AZ-James/Original-Space/电赛2026/技术报告/stm32程序逻辑图.png

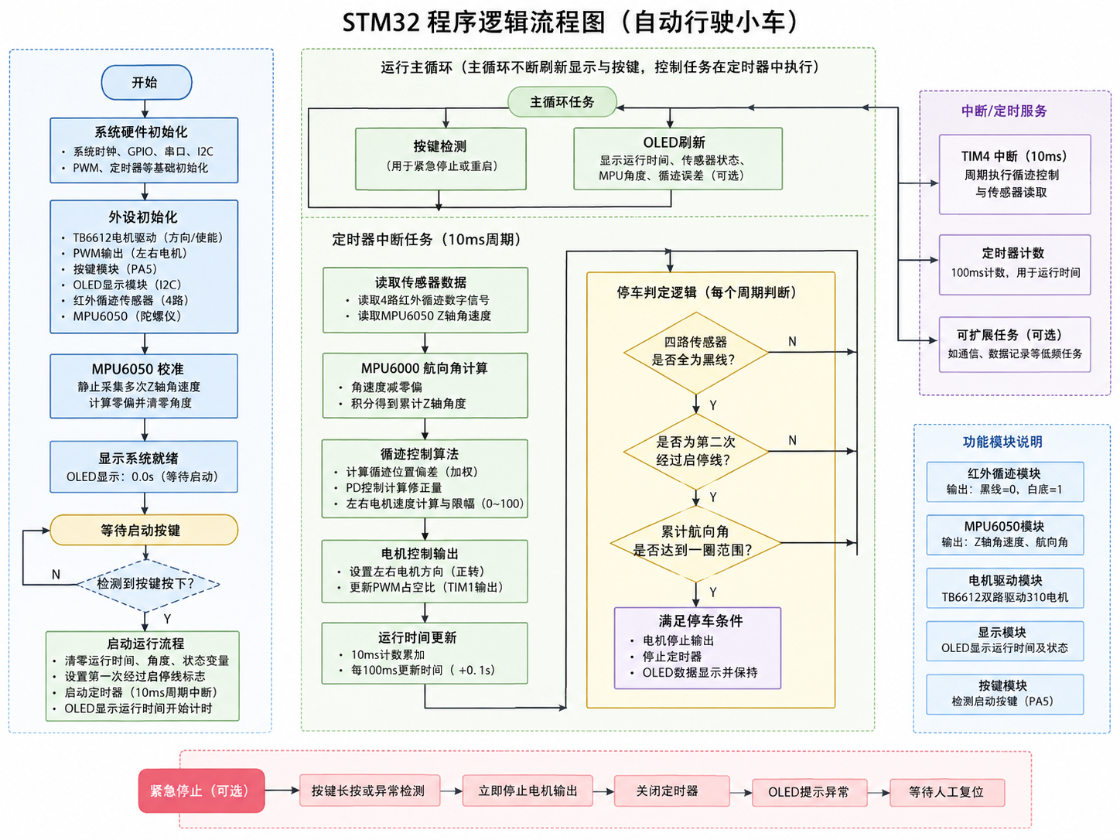
电赛2026/技术报告/stm32程序逻辑图.png
