AZ-James/Original-Space/README.md

# Original Space

## 说明
***A-Zealous*** 的元初空间，大存档器

后面闲着没事干可能也会传一些值得上传的东西上来吧
<p align="right"><i>（写于2026.11.4）</i></p>

## 上传摘要
- 26.11.10 对2026电赛的一部分代码与资料进行了留档
- 26.11.11 上传电赛视觉代码和技术报告资料

  其中视觉代码作者为队友 ***BrightGates***（https://github.com/BrightGates）

  底盘代码一部分为 ***桂花韵龙井*** 编写
