AZ-James/Original-Space/电赛2026/视觉代码/树莓派完整快照/diansai/README.md

# diansai ????

??????Python????????????????`tracker.service`????????

## ??

- `detect_rect.py`???????????????????????
- `vision_observe.py`???????????????????
- `ball_controller.py`???????????????????
- `pulse_controller.py`?????????????????????????
- `motor_init.py`??????????/?????
- `zdt_motor.py`?ZDT??????????????????
- `test_enc_simple.py`????????????????

## ????????????

```bash
python3 pulse_controller.py --target centre --max-pulses 6
python3 pulse_controller.py --target left --max-pulses 10
python3 pulse_controller.py --target right --max-pulses 10
```

????8????????????????12???????0.10--0.15??
??????????2????????????????????????????????
????????????120 px/s???????????????0??

## ??????

???????????????????

```text
????????
(69,243), (567,238), (567,277), (69,290)
??????????????????
(95,243), (542,238), (542,277), (95,290)
?????????????
(355,261), (211,264), (492,257)
```

???????????**??????????**??????????????????????????????
??????????????????/???????????
?????Hough??????????????????????

??????

```bash
cd /home/bg/diansai
python3 vision_observe.py
```

?????????????

```bash
python3 detect_rect.py
```

## ????/??

```bash
python3 motor_init.py
```

??????????????????`L/U`???

## ????????????

```bash
python3 pulse_controller.py --target centre --max-pulses 6
python3 pulse_controller.py --target left --max-pulses 10
python3 pulse_controller.py --target right --max-pulses 10
```

????8????????????????12???????0.10--0.15??
??????????2????????????????????????????????
????????????120 px/s???????????????0??

## ??????

???????????????????

```bash
python3 ball_controller.py --dry-run
```

???????????

```bash
python3 ball_controller.py --port /dev/ttyUSB0
```

???????????????????????????????????????????
???????????2?????`Space`???????????????????????
????????????????`--motor-sign 1`????????????????
`--motor-sign -1`?

????

- `Space`????????????????/???
- `1/2/3`????????????
- `E`?????????????????
- ????150 px/s????????`OVERSPEED`???????`Space`???
- `Q/Esc`?????????

## ????

?????????????????????266??????29.925????????
???30.0375??267???????????18????????????24??
????????????????????????????????????

## ????????????

```bash
python3 pulse_controller.py --target centre --max-pulses 6
python3 pulse_controller.py --target left --max-pulses 10
python3 pulse_controller.py --target right --max-pulses 10
```

????8????????????????12???????0.10--0.15??
??????????2????????????????????????????????
????????????120 px/s???????????????0??

## ??????

- ?????RS485???????????????????
- ????USB-RS485 `/dev/ttyUSB0`?
- ??????GPIO UART????RS485 A/B?
- ??????PL2303/FTDI??RTS?
- ??????????????????
- `python3 test_enc_simple.py --port /dev/ttyUSB0`???????
- `python3 zdt_motor.py --port /dev/ttyUSB0`??????????????

## 2026-08-01 当前推荐控制方案

当前推荐入口为 `pulse_controller.py`。它不再使用固定“角度×时间→位移”模型，而是采用轻量反馈：5.5°起步、未克服静摩擦时每次增加0.5°、最高7°；检测到运动立即回零，钢球稳定后重新测量实际落点。环境较稳定，因此只使用简单中位数/MAD滤噪和3秒稳定窗口，不进行复杂在线辨识。

```bash
python3 pulse_controller.py --target centre --max-pulses 8
python3 pulse_controller.py --target left --max-pulses 10
python3 pulse_controller.py --target right --max-pulses 10
```

轨道和目标坐标统一在 `vision_calibration.json` 中调整。完整实验依据、安全约束和文件说明见 `CONTROL_UPDATE_2026-08-01.md`。旧版已备份为 `pulse_controller_before_adaptive.py`，仅供回看。

注意：电机 `enable()` 后第一条位置命令前必须等待至少0.5秒；当前程序等待0.6秒。±30°硬限位、边缘保护、视觉丢失回零和超速中止始终有效。
