AZ-James/Original-Space/电赛2026/视觉代码/树莓派完整快照/diansai/CONTROL_UPDATE_2026-08-01.md

# 2026-08-01 鲁棒控制更新

## 核心结论

钢球系统不能使用“某角度持续某时间必然移动固定像素”的精确模型。轻微弧度、动静摩擦差异、每次装配/锁定偏移和钢球反射都会改变结果。一次实验得到的角度、速度和位移只能用于确定保守范围，不能当作固定标定常数。

当前 `pulse_controller.py` 已改成反馈驱动的自适应控制：

1. 每次动作前重新测量钢球位置和当前画面噪声；
2. 从 5.5°开始，未克服静摩擦时逐级增加；右侧上坡区14°仍不足，但+15°测试产生约204 px/s峰值，因此正式程序上限恢复到14°，禁止继续盲目增角；
3. 运动触发阈值由当前位置噪声的中位数绝对偏差（MAD）计算，并设宽松上下界；
4. 检测到真实位移或同方向速度后立即快速回到 0°；
5. 不预测滑行距离，等待真正稳定后重新测量落点，再决定下一步；
6. 换向后重新从小倾角搜索，不假设左右摩擦相同；
7. 视觉丢失、速度过高、进入边缘保护区或长期不稳定时均回零并中止；
8. ±30°机械硬限位仍独立存在（266 脉冲 = 29.925°），任何控制参数都不能越过；当前正式控制另设 14°上限。

轨道由右侧电机带动时会靠近或远离镜头，镜头畸变使静止钢球在倾斜画面中也产生位置相关的像素偏移，而且越靠右越明显。因此倾斜状态的坐标只用于相对运动检测；只有回到0°并稳定后，才与三个目标坐标比较。

环境目前较稳定，因此只保留小范围角度自适应和简单噪声统计，不做复杂在线模型辨识。稳定判定窗口为 3 秒，兼顾可靠性和控制速度。

后续右移测试发现，平台开始倾斜时滤波速度可能先产生短暂尖峰，而钢球原始位置尚未发生同方向位移。因此运动启动条件已进一步简化为“原始位置确实向目标方向移动”；速度不再触发回零，只用于超速安全检查。

三个目标点和轨道四点继续从 `vision_calibration.json` 读取，装配小幅位移时只需修改该文件，不应修改控制算法。

## 本轮有效实验

- 当前锁定零位下，钢球曾在约 x=403 静止；这只是静摩擦造成的一个静止位置，不是唯一固定“最低点”。
- 在 x≈403 时，-1° 至 -5°未产生可信的永久运动；-6°能克服静摩擦。
- 快速 6°阶跃即使很短也会产生过大速度：一次 +6°约 0.124 秒后回零，钢球最大观测速度约 358 px/s，并接近右边缘。此方式已判定不适合继续使用。
- 将倾斜过程降到 5 RPM，并在检测到运动后回零，从 x≈413.6 到 x≈376.6，最大速度约 85.9 px/s。
- 再改为 3 RPM 慢速接近、直接使用原始视觉位置提前触发、80 RPM快速回零后，从 x≈376.7 到 x≈363～364，最大速度约 51.3 px/s。
- 中间目标 x=355，当前钢球距目标约 9 px，已进入 ±15 px 容差；测试结束时已发送绝对 0°。

上述数值只记录实验事实。程序不会依赖“每次移动约 13 px”之类的假设。

## 文件状态

- `pulse_controller.py`：新的自适应、事件触发控制器；已通过语法和参数检查。
- `pulse_controller_before_adaptive.py`：修改前备份，仅用于回看，禁止作为当前实机方案运行。
- `motion_observe_headless.py`：纯视觉无界面观察，不打开电机串口。
- `hold_angle_test.py`、`impulse_test.py`、`slow_tilt_test.py`：本轮实验脚本，不作为比赛入口。
- `detect_rect.py`：用户原始视觉测试程序，保持原样。

## 运行方式

先只观察：

```bash
cd /home/bg/diansai
python3 motion_observe_headless.py
```

控制到目标：

```bash
python3 pulse_controller.py --target centre --max-pulses 8
python3 pulse_controller.py --target left --max-pulses 10
python3 pulse_controller.py --target right --max-pulses 10
```

电机板没有返回数据。`enable()` 后必须等待至少 0.5 秒再发送第一条位置命令，否则第一条命令可能被忽略；当前代码等待 0.6 秒。无论正常完成还是异常退出，控制器都会在 `finally` 中再次发送绝对 0°。

## 尚需验证

自适应程序已经整合本轮有效策略，但尚未从远距离分别完整跑通左、中、右三个目标。后续验证必须逐个目标进行，观察真实落点后反馈调整，不能用一次实验拟合出的精确模型直接放大运行。
