AZ-James/Original-Space/电赛2026/R1三轮、四轮两驱小车底板（方形）-二维图纸.dxf

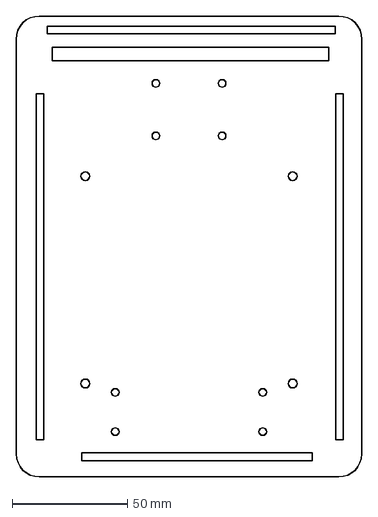
[picture p14: CAD file, 2026-11-10]
电赛2026/R1三轮、四轮两驱小车底板（方形）-二维图纸.dxf
150.0 x 200.0 mm
