AZ-James/Original-Space/电赛2026/车体建模/摆杆装配.stp

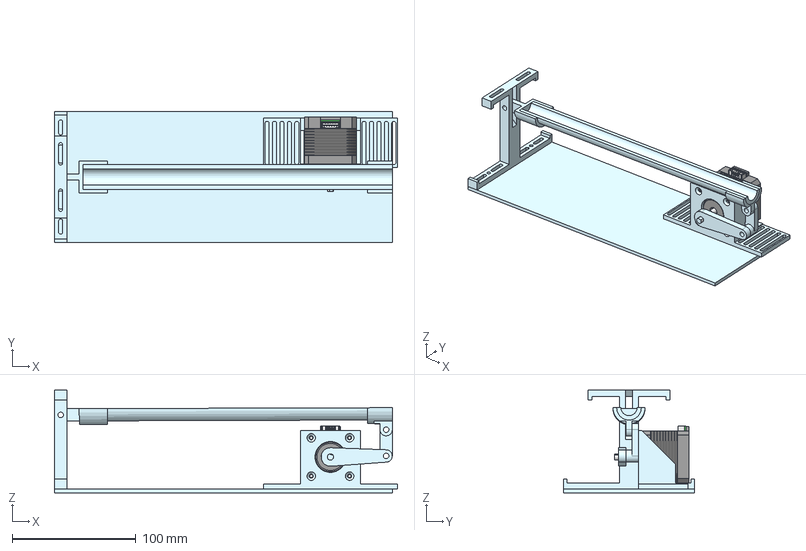
[picture p15: CAD file, 2026-11-10]
电赛2026/车体建模/摆杆装配.stp
277.2 x 106.0 x 83.0 mm
菁攫
42电机底座
摄像头支架及活页
步进连杆
Bottom
Sheet_metal
Top_body
Axis
625ZZ_001 x 2
Sticker
C-440054-6
PCB
Conn_cover
M3x16-Vis x 4
水管活页
阨奪
水管连杆
蟀裝2
