AZ-James/Original-Space/电赛2026/Drawing1.dxf

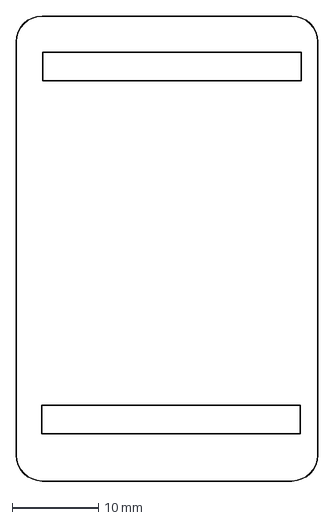
[picture p16: CAD file, 2026-11-10]
电赛2026/Drawing1.dxf
35.0 x 54.0 mm
