AZ-James/Original-Space/电赛2026/车体建模/树莓派底座.3mf

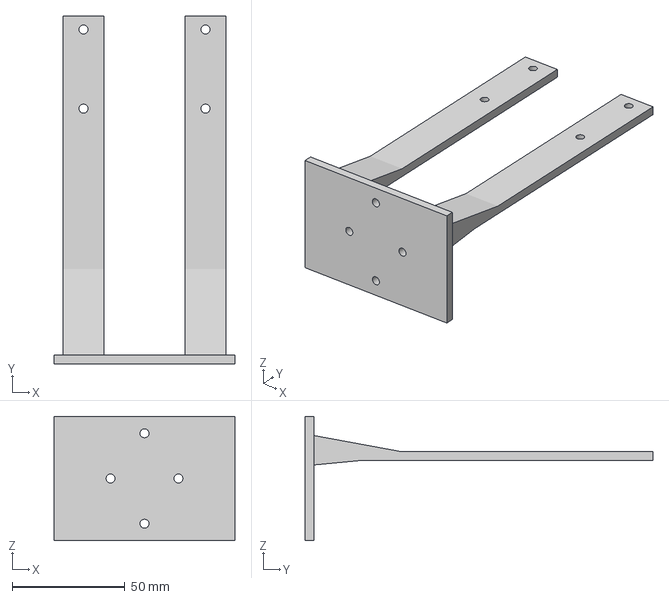
[picture p17: CAD file, 2026-11-10]
电赛2026/车体建模/树莓派底座.3mf
80.0 x 154.0 x 55.0 mm
