AZ-James/Original-Space/电赛2026/车体建模/摄像机支架总汇总.3mf

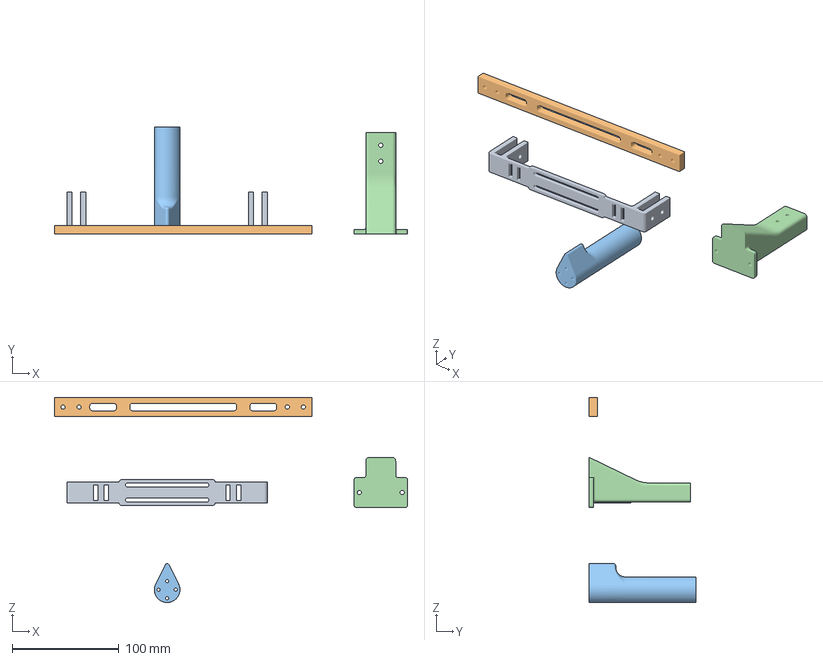
[picture p18: CAD file, 2026-11-10]
电赛2026/车体建模/摄像机支架总汇总.3mf
330.5 x 100.0 x 192.0 mm
实体5
实体6
实体7
实体8
