AZ-James/Original-Space/电赛2026/车体建模/车屁股.3mf

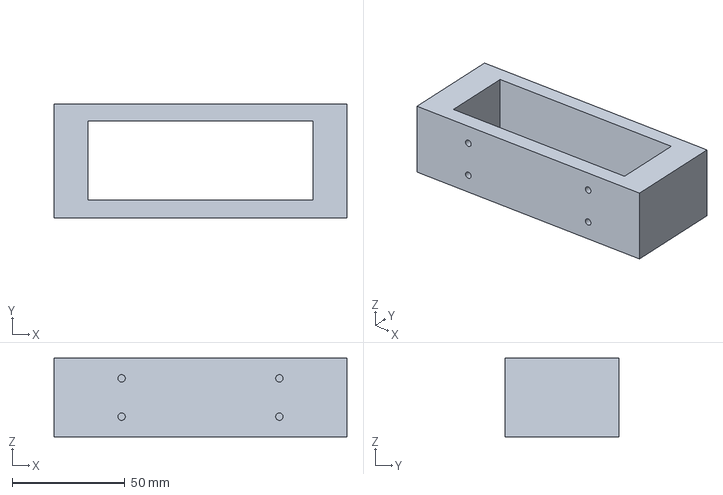
[picture p19: CAD file, 2026-11-10]
电赛2026/车体建模/车屁股.3mf
130.0 x 50.5 x 35.0 mm
