AZ-James/Original-Space/电赛2026/车体建模/摄像头顶部支架最终坚固备用版本.3mf

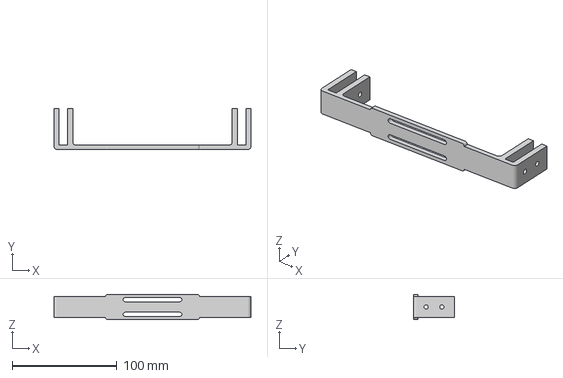
[picture p20: CAD file, 2026-11-10]
电赛2026/车体建模/摄像头顶部支架最终坚固备用版本.3mf
188.0 x 39.0 x 24.0 mm
