AZ-James/Original-Space/电赛2026/车体建模/水管架.3mf

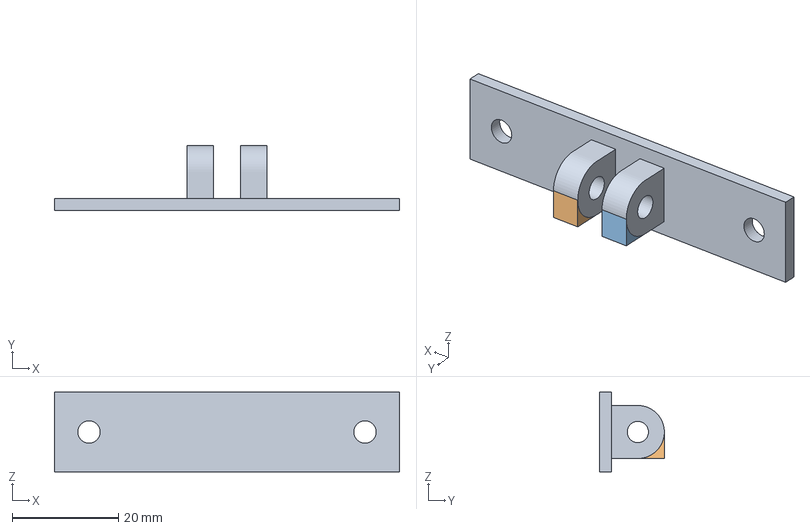
[picture p22: CAD file, 2026-11-10]
电赛2026/车体建模/水管架.3mf
65.0 x 12.2 x 15.0 mm
实体7
实体8
实体9
