AZ-James/Original-Space/电赛2026/车体建模/最后的底座必过版.3mf

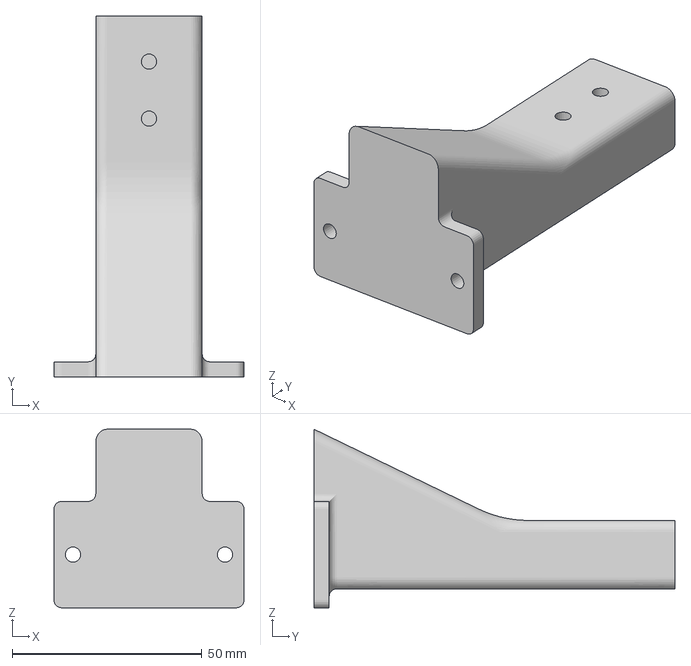
[picture p23: CAD file, 2026-11-10]
电赛2026/车体建模/最后的底座必过版.3mf
50.0 x 95.0 x 47.0 mm
