AZ-James/Original-Space/电赛2026/车体建模/中国塑料10g.3mf

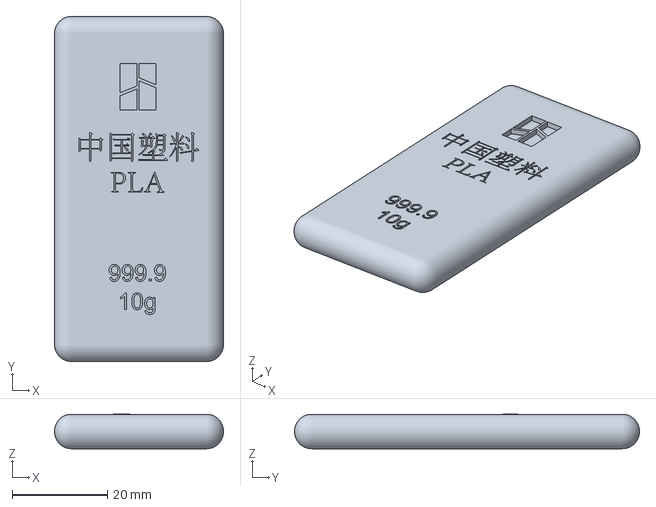
[picture p24: CAD file, 2026-11-10]
电赛2026/车体建模/中国塑料10g.3mf
35.5 x 72.5 x 7.25 mm
