AZ-James/Original-Space/电赛2026/车体建模/大二组支架.3mf

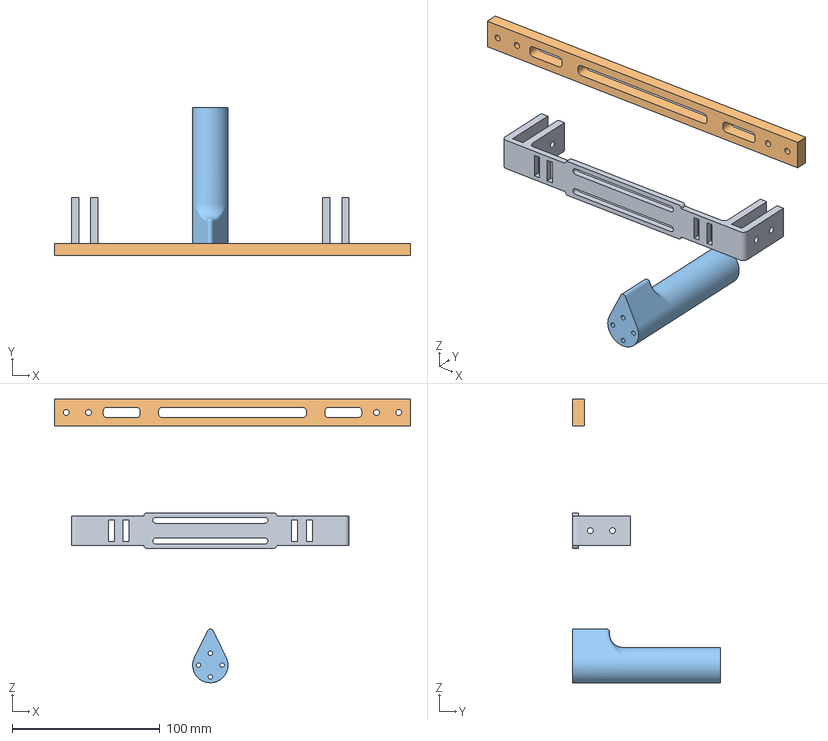
[picture p25: CAD file, 2026-11-10]
电赛2026/车体建模/大二组支架.3mf
241.0 x 100.0 x 192.0 mm
实体5
实体6
实体7
