AZ-James/Original-Space/电赛2026/车体建模/摄像头新支架.3mf

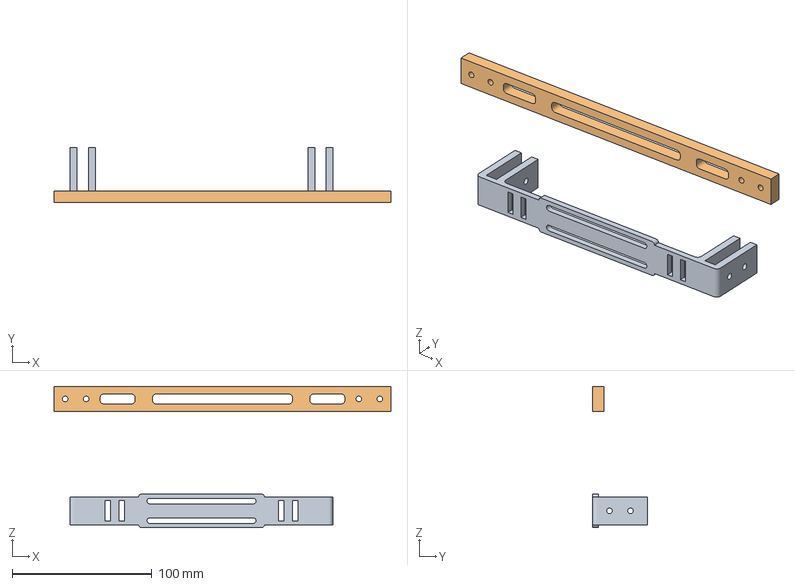
[picture p26: CAD file, 2026-11-10]
电赛2026/车体建模/摄像头新支架.3mf
241.0 x 39.0 x 101.0 mm
实体5
实体6
