AZ-James/Original-Space/电赛2026/车体建模/树莓派外壳.3mf

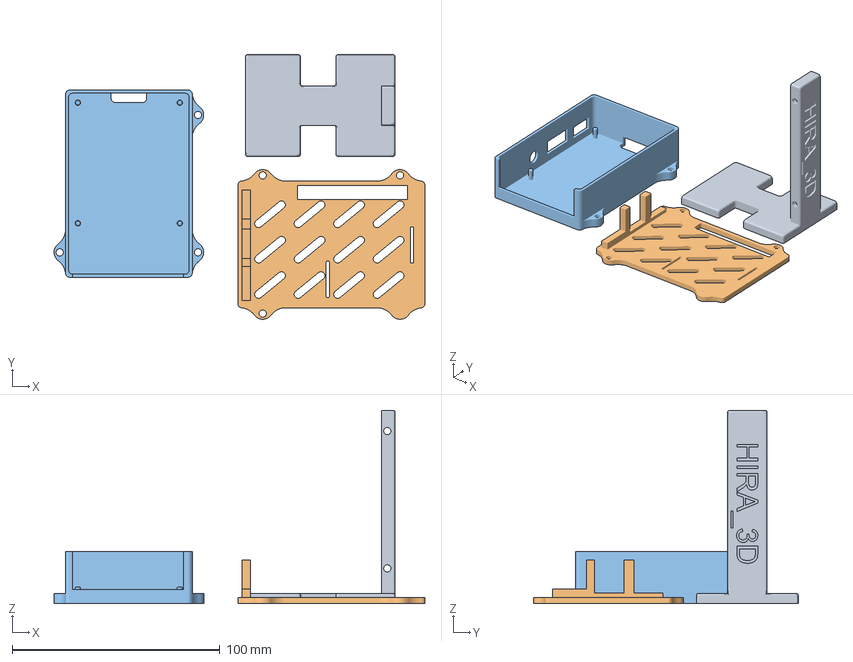
[picture p27: CAD file, 2026-11-10]
电赛2026/车体建模/树莓派外壳.3mf
178.4 x 127.2 x 93.0 mm
Corps6
Corps4
Corps3
