AZ-James/Original-Space/电赛2026/车体建模/树莓派悬空平台.3mf

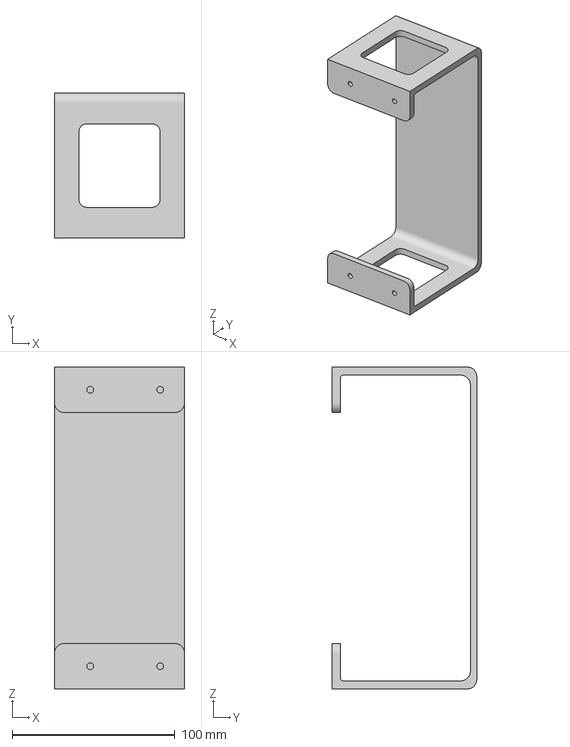
[picture p28: CAD file, 2026-11-10]
电赛2026/车体建模/树莓派悬空平台.3mf
80.0 x 89.0 x 198.0 mm
