AZ-James/Original-Space/电赛2026/车体建模/摆杆.3mf

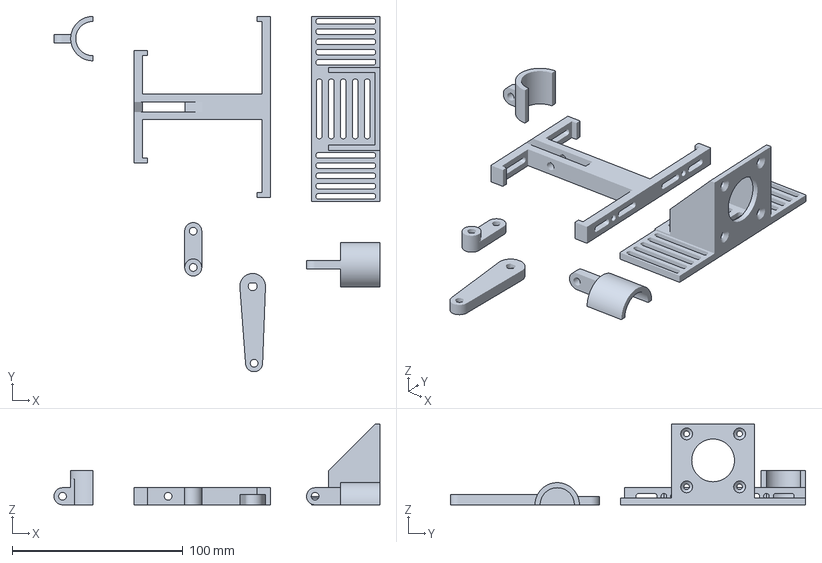
[picture p29: CAD file, 2026-11-10]
电赛2026/车体建模/摆杆.3mf
190.8 x 208.0 x 47.2 mm
