AZ-James/Original-Space/电赛2026/车体建模/树莓派悬空支架最终版.3mf

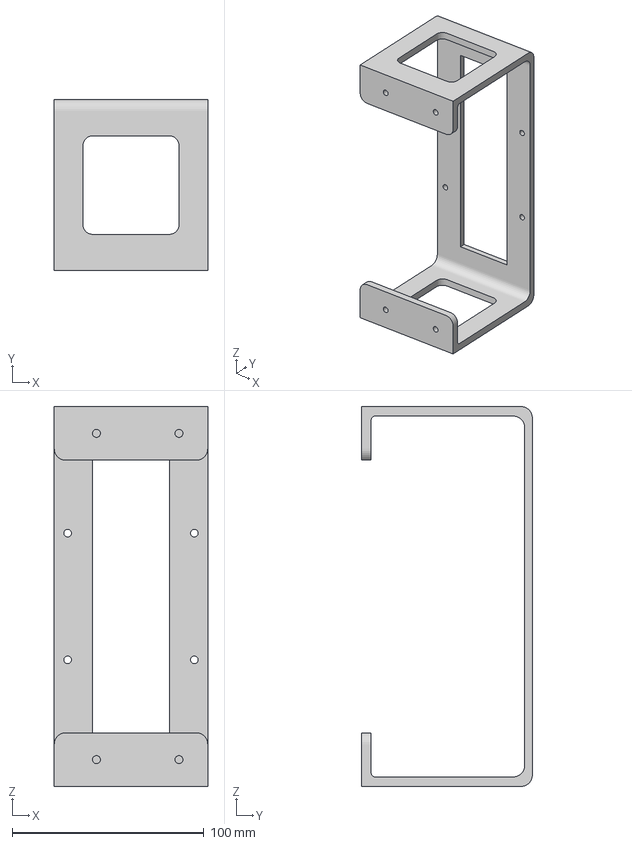
[picture p30: CAD file, 2026-11-10]
电赛2026/车体建模/树莓派悬空支架最终版.3mf
80.0 x 89.0 x 198.0 mm
