AZ-James/Original-Space/电赛2026/车体建模/树莓派机械臂.3mf

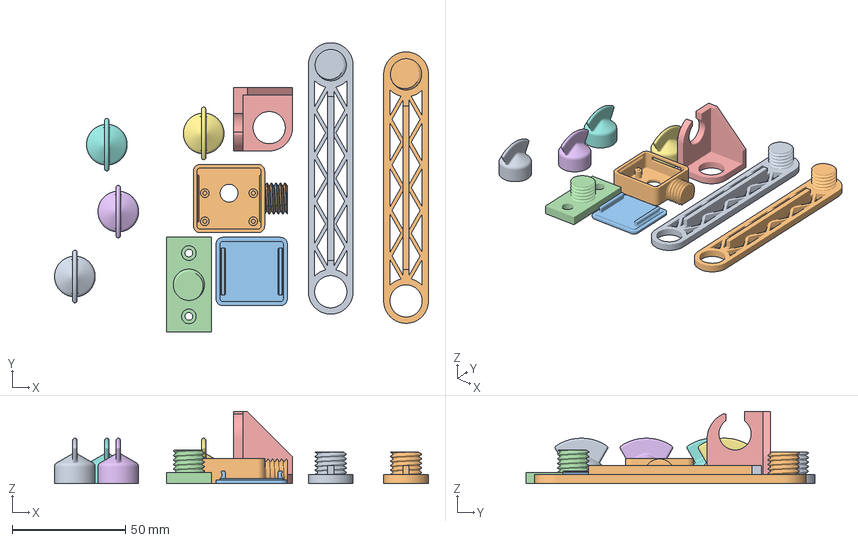
[picture p31: CAD file, 2026-11-10]
电赛2026/车体建模/树莓派机械臂.3mf
165.4 x 128.0 x 32.0 mm
120mm_Arm.stl x 2
Pi_Camera_Body.stl
Pi_Camera_Back.stl
Profile_Mount.stl
Arm_Bracket.stl
M14_Nut.stl x 4
