AZ-James/Original-Space/(list of files, cad)

Other CAD files:
电赛2026/车体建模/摄像头支架底座最终版.3mf
电赛2026/车体建模/摆杆.stl
