AZ-James/Original-Space/电赛2026/视觉代码/树莓派完整快照/diansai/PROJECT_LOG.md

# 电赛项目状态记录

更新时间：2026-08-01

## 1. 当前目标

摄像头检测管道内钢球位置，电机控制管道倾角，使钢球稳定到三个目标点之一。

当前工作分成三层：

1. 视觉层：稳定输出球的位置、速度、置信度和目标误差；
2. 电机层：快速发送使能、停止和小角度运动命令；
3. 控制层：视觉反馈 + 限幅PD控制（尚未接入，等待视觉实测）。

## 2. 已确认硬件

### 电机与RS485

- 电机：ZDT X42S；
- 地址：`0x01`；
- 波特率：115200，8N1；
- 固定校验字节：`0x6B`；
- 菜单串口功能：`UART_FUN`；
- 响应设置测试过 `Receive`、`Both`、`Other`；
- PL2303：树莓派 `/dev/ttyUSB0`，Windows `COM7`；
- FTDI模块：Windows `COM8`。

RS485接线：

```text
USB-RS485 A+  -> 电机 R/A/H（RS485板上为A）
USB-RS485 B-  -> 电机 T/B/L（RS485板上为B）
GND           -> 不连接（RS485隔离侧）
```

### 重要电气结论

`UART_FUN` 是串口命令功能，不会把RS485通信小板转换成TTL接口。
端子 `R/A/H`、`T/B/L` 的含义取决于电机安装的通信小板：TTL板为R/T，
RS485板为A/B，CAN板为H/L。树莓派GPIO不能直接连接当前RS485板的A/B。

## 3. 通信排查最终结果

已在Windows进行PL2303与FTDI模块交叉测试：

- PL2303 -> FTDI：三种RTS模式均完整收到测试字节；
- FTDI -> PL2303：三种RTS模式均完整收到测试字节；
- 两个模块在115200下均可双向通信；
- RTS高、低和发送后切换均不影响结果，模块具有自动方向控制。

两个模块分别连接电机后：

- `01 1F 6B` 读取版本：无返回；
- `01 3A 6B` 读取状态：无返回；
- `01 31 6B` 读取编码器：无返回。

因此已排除树莓派、Windows、PL2303、FTDI、RTS时序和Python权限问题。
当前结论是电机侧RS485通信小板的发送路径或固件响应异常。

直接GPIO测试收到连续`00`，原因是把TTL UART接到了RS485差分接口，该结果无效，
并且这种接法不应再次使用。

## 4. 当前软件结构

| 文件 | 用途 | 状态 |
|---|---|---|
| `zdt_motor.py` | ZDT电机控制与可选查询 | 控制默认纯发送，不等待无效回复 |
| `motor_init.py` | 手动LOCK/UNLOCK界面 | 保留已验证功能，暂时禁用编码器轮询 |
| `test_enc_simple.py` | 安全只读通信诊断 | 不会使能或移动电机 |
| `detect_rect.py` | 原始钢球检测程序 | 已按用户要求完整恢复 |
| `ball_controller.py` | 固定坐标视觉+电机闭环 | 独立文件，等待先做dry-run验证 |
| `requirements.txt` | 当前依赖版本记录 | 使用系统Python，不创建虚拟环境 |
| `PROTOCOL.md` | 已确认协议与安全约束 | 参考文件 |

旧文件备份位于 `.backup_before_refactor/`。

## 5. 视觉程序（原版已恢复）

### 操作流程

1. 点击管道有效区域四个角点，按Enter；
2. 点击三个目标点，按Enter；
3. 自动检测钢球并显示到三个参考点的距离。

### 按键

| 按键 | 功能 |
|---|---|
| Enter | 确认当前标定阶段 |
| R | 清空并重新标定 |
| T | 键盘输入标定坐标 |
| Q / Esc | 退出 |

原版使用旋转校正和一维局部标准差寻找钢球，输出到三个参考点的像素距离。
视觉代码不导入电机模块，也不会发出电机命令。后续如需改进，应另建新文件，
不再覆盖`detect_rect.py`。

## 6. 电机程序原则

因为当前电机不返回数据，控制命令不能等待ACK，否则每条命令会阻塞视觉循环。
`zdt_motor.py`默认：

- 不操作RTS；
- 控制命令写入并flush后立即返回；
- 查询超时为80ms；
- 查询严格检查长度、地址和末尾`0x6B`；
- 直接运行脚本不会移动电机。

`motor_init.py`继续提供已经验证的手动锁定和解锁。编码器轮询由
`READ_ENCODER = False`关闭；更换正常通信板后才可设为`True`。

## 7. 系统状态

- `tracker.service`已停止并禁用；
- 原服务指向不存在的`start.sh`，造成连续重启；
- 当前不创建启动脚本，不自动启动GUI；
- 树莓派`/dev/serial0`仍被Linux串口控制台使用，不应用于项目；
- 项目使用USB-RS485 `/dev/ttyUSB0`；
- 暂时使用系统`/usr/bin/python3`，避免比赛阶段重装OpenCV。

## 8. ??????

1. ????????????????????????
2. `vision_observe.py`????????????????/???????
3. ?????????????????????
4. ?????????????????`motor_sign=+1`?
5. ????????????????????????
6. ???????????????????????????????

## 9. ???????????

?????????????????????????????????
????????????????????????

```text
????????(69,243), (567,238), (567,277), (69,290)
????????????????(95,243), (542,238), (542,277), (95,290)
?????(355,261)
?????(211,264)
?????(492,257)
```

`detect_rect.py`????????????????`vision_observe.py`?`ball_controller.py`
?????????????/????????????????????????
???Hough??????????????????????????????

??????????????????????????????Space??????????

1. ?????????
2. ?????????10???
3. ???????6px/s?
4. ??????2??

????????`01 0A 6D 6B`?????????????????????????
????????266?????29.925?????????30.0375??267????
??????????18??????????????24???????????
??????`motor_sign=+1`????????????????????
## 10. 2026-08-01??????

- ??????????????????????????
- ??????????????????????????
- ????MJPG??????????????????45 FPS?
- ??????????????????????????????
- ???????150 px/s????????????????????????
- ????????????????36/36????????????
- ??+8??0.2?????????????????????????0.05--0.10???????
- ???????????18??????????266?????29.925???
- ?????Python????`vision_calibration.json`??????????????????
## 11. ??????????

- ??8??0.10???????????2?????????????x=288.3???x=252.7?
- ?????41.3px/s???????????????
- x?252??????????????????
- x?264.7???????????8??10??12?????-3??????0.5???????
- ?????????????????????12??????????120px/s?
- ?????????25px/s???????2???????????????????????????????
# 2026-08-01 鲁棒控制更新

## 核心结论

钢球系统不能使用“某角度持续某时间必然移动固定像素”的精确模型。轻微弧度、动静摩擦差异、每次装配/锁定偏移和钢球反射都会改变结果。一次实验得到的角度、速度和位移只能用于确定保守范围，不能当作固定标定常数。

当前 `pulse_controller.py` 已改成反馈驱动的自适应控制：

1. 每次动作前重新测量钢球位置和当前画面噪声；
2. 从 5.5°开始，未克服静摩擦才以 0.5°逐级增加，最高只到 7°；
3. 运动触发阈值由当前位置噪声的中位数绝对偏差（MAD）计算，并设宽松上下界；
4. 检测到真实位移或同方向速度后立即快速回到 0°；
5. 不预测滑行距离，等待真正稳定后重新测量落点，再决定下一步；
6. 换向后重新从小倾角搜索，不假设左右摩擦相同；
7. 视觉丢失、速度过高、进入边缘保护区或长期不稳定时均回零并中止；
8. ±30°机械硬限位仍独立存在（266 脉冲 = 29.925°），任何控制参数都不能越过；日常自适应动作另设 7°保守上限。

环境目前较稳定，因此只保留小范围角度自适应和简单噪声统计，不做复杂在线模型辨识。稳定判定窗口为 3 秒，兼顾可靠性和控制速度。

三个目标点和轨道四点继续从 `vision_calibration.json` 读取，装配小幅位移时只需修改该文件，不应修改控制算法。

## 本轮有效实验

- 当前锁定零位下，钢球曾在约 x=403 静止；这只是静摩擦造成的一个静止位置，不是唯一固定“最低点”。
- 在 x≈403 时，-1° 至 -5°未产生可信的永久运动；-6°能克服静摩擦。
- 快速 6°阶跃即使很短也会产生过大速度：一次 +6°约 0.124 秒后回零，钢球最大观测速度约 358 px/s，并接近右边缘。此方式已判定不适合继续使用。
- 将倾斜过程降到 5 RPM，并在检测到运动后回零，从 x≈413.6 到 x≈376.6，最大速度约 85.9 px/s。
- 再改为 3 RPM 慢速接近、直接使用原始视觉位置提前触发、80 RPM快速回零后，从 x≈376.7 到 x≈363～364，最大速度约 51.3 px/s。
- 中间目标 x=355，当前钢球距目标约 9 px，已进入 ±15 px 容差；测试结束时已发送绝对 0°。

上述数值只记录实验事实。程序不会依赖“每次移动约 13 px”之类的假设。

## 文件状态

- `pulse_controller.py`：新的自适应、事件触发控制器；已通过语法和参数检查。
- `pulse_controller_before_adaptive.py`：修改前备份，仅用于回看，禁止作为当前实机方案运行。
- `motion_observe_headless.py`：纯视觉无界面观察，不打开电机串口。
- `hold_angle_test.py`、`impulse_test.py`、`slow_tilt_test.py`：本轮实验脚本，不作为比赛入口。
- `detect_rect.py`：用户原始视觉测试程序，保持原样。

## 运行方式

先只观察：

```bash
cd /home/bg/diansai
python3 motion_observe_headless.py
```

控制到目标：

```bash
python3 pulse_controller.py --target centre --max-pulses 8
python3 pulse_controller.py --target left --max-pulses 10
python3 pulse_controller.py --target right --max-pulses 10
```

电机板没有返回数据。`enable()` 后必须等待至少 0.5 秒再发送第一条位置命令，否则第一条命令可能被忽略；当前代码等待 0.6 秒。无论正常完成还是异常退出，控制器都会在 `finally` 中再次发送绝对 0°。

## 尚需验证

自适应程序已经整合本轮有效策略，但尚未从远距离分别完整跑通左、中、右三个目标。后续验证必须逐个目标进行，观察真实落点后反馈调整，不能用一次实验拟合出的精确模型直接放大运行。
