AZ-James/Original-Space/电赛2026/底盘代码/E2/E2/hardware/Buzzer.c

#include "Buzzer.h"
#include "stm32f10x.h"

void buzzer_init(void)
{
    GPIO_InitTypeDef GPIO_InitStructure;
    
    RCC_APB2PeriphClockCmd(RCC_APB2Periph_GPIOA, ENABLE);
    
    GPIO_InitStructure.GPIO_Pin = GPIO_Pin_11;
    GPIO_InitStructure.GPIO_Mode = GPIO_Mode_Out_PP;
    GPIO_InitStructure.GPIO_Speed = GPIO_Speed_50MHz;
    GPIO_Init(GPIOA, &GPIO_InitStructure);
    
    buzzer_off();
}

void buzzer_on(void)
{
   GPIO_SetBits(GPIOA, GPIO_Pin_11);
}

void buzzer_off(void)
{
    GPIO_ResetBits(GPIOA, GPIO_Pin_11);
}
