AZ-James/Original-Space/电赛2026/视觉代码/树莓派完整快照/diansai/snapshot_once.py

import cv2

c = cv2.VideoCapture(0)
frame = None
for _ in range(30):
    ok, candidate = c.read()
    if ok:
        frame = candidate
c.release()
if frame is None:
    raise RuntimeError("camera read failed")
cv2.imwrite("current_frame.jpg", frame)
