AZ-James/Original-Space/(commit log)

2026-11-03 测试第一次提交
2026-11-03 新增橘子
2026-11-03 添加荔枝
2026-11-04 学git的说明
2026-11-11 修改readme
2026-11-11 竞赛留档
2026-11-11 Revise README 版本说明
    Updated README to include project description and upload summary.
